NoahDorfman00/deskcal/hardware/stand/stl/clip.stl

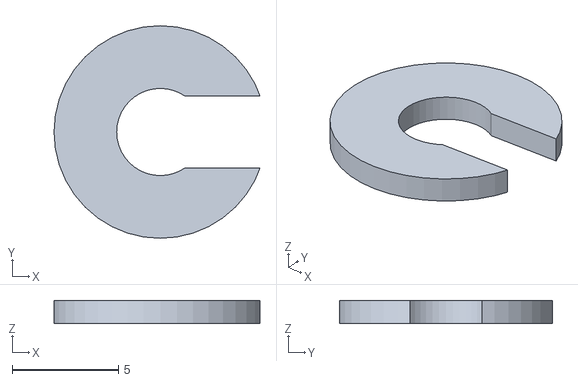
[picture p9: CAD file, 2026-10-13]
hardware/stand/stl/clip.stl
9.69 x 10.0 x 1.10
