NoahDorfman00/deskcal/hardware/stand/stl/handle.stl

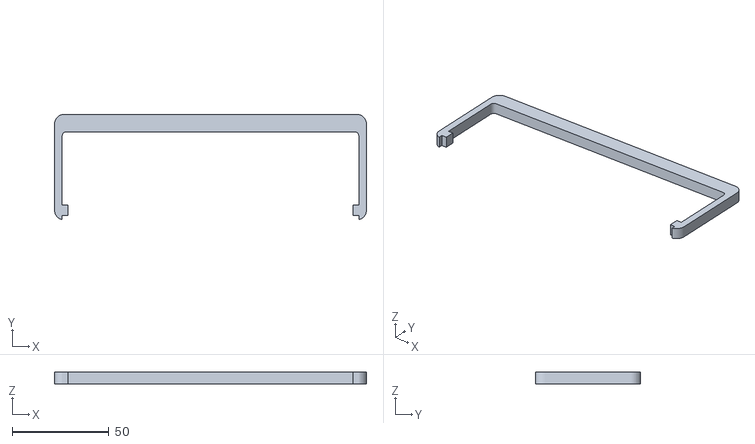
[picture p10: CAD file, 2026-10-13]
hardware/stand/stl/handle.stl
161.1 x 54.4 x 6.00
