NoahDorfman00/deskcal/hardware/stand/stl/bnc.stl

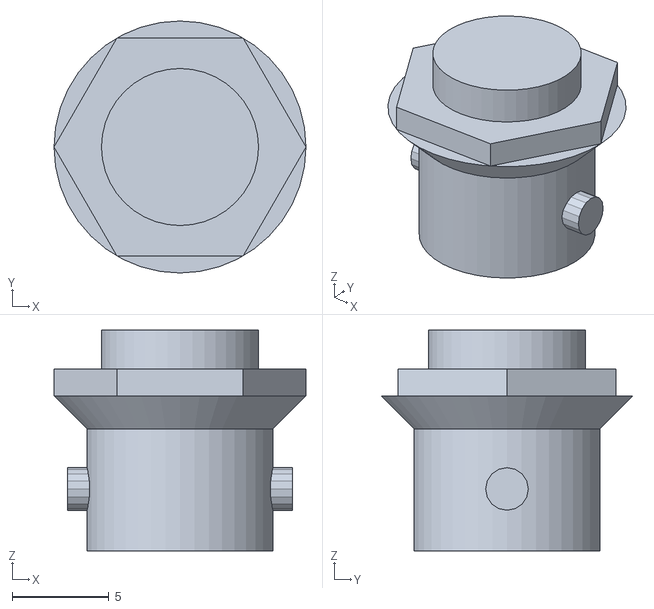
[picture p11: CAD file, 2026-10-13]
hardware/stand/stl/bnc.stl
13.0 x 13.0 x 11.4
