NoahDorfman00/deskcal/hardware/stand/stl/knob_big.stl

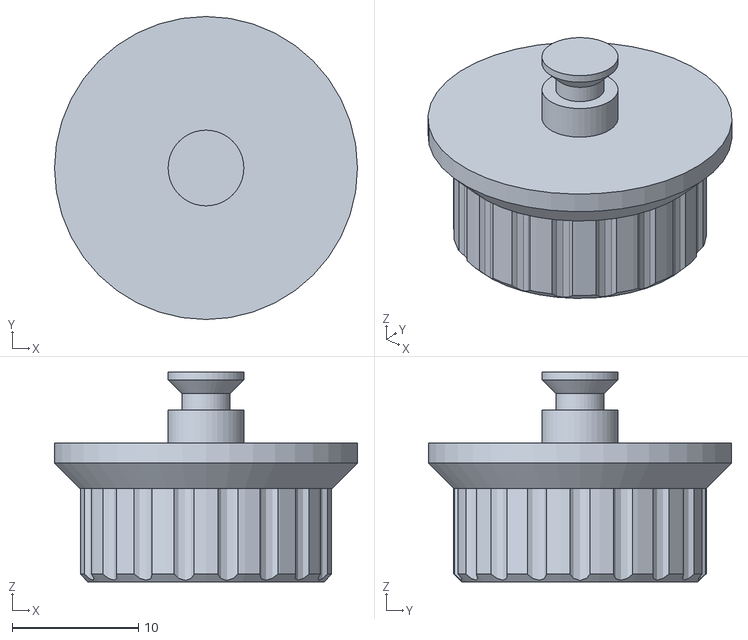
[picture p12: CAD file, 2026-10-13]
hardware/stand/stl/knob_big.stl
24.0 x 24.0 x 16.6
