NoahDorfman00/deskcal/hardware/stand/stl/lock.stl

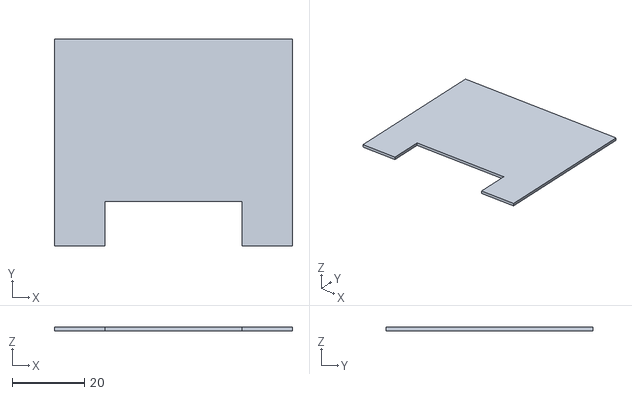
[picture p13: CAD file, 2026-10-13]
hardware/stand/stl/lock.stl
66.0 x 57.5 x 1.00
