NoahDorfman00/deskcal/hardware/stand/stl/knob_small.stl

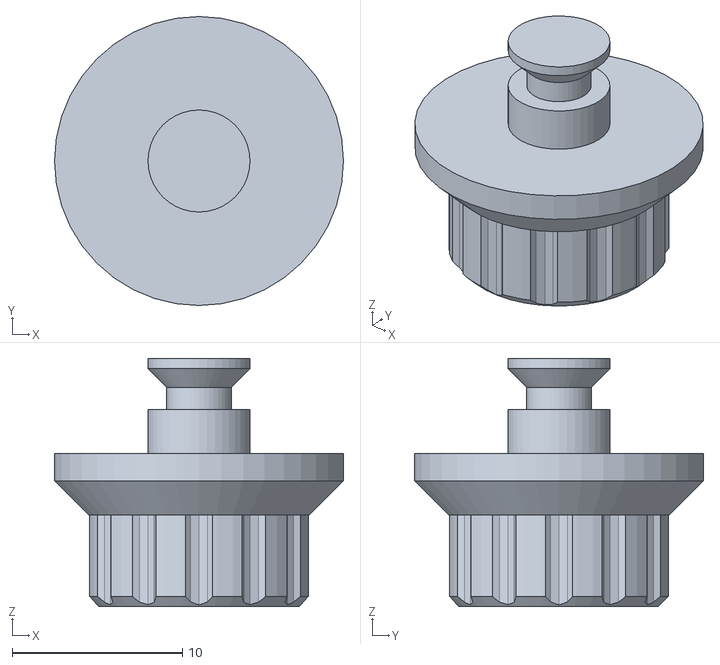
[picture p14: CAD file, 2026-10-13]
hardware/stand/stl/knob_small.stl
17.0 x 17.0 x 14.6
