NoahDorfman00/deskcal/hardware/stand/stl/body.stl

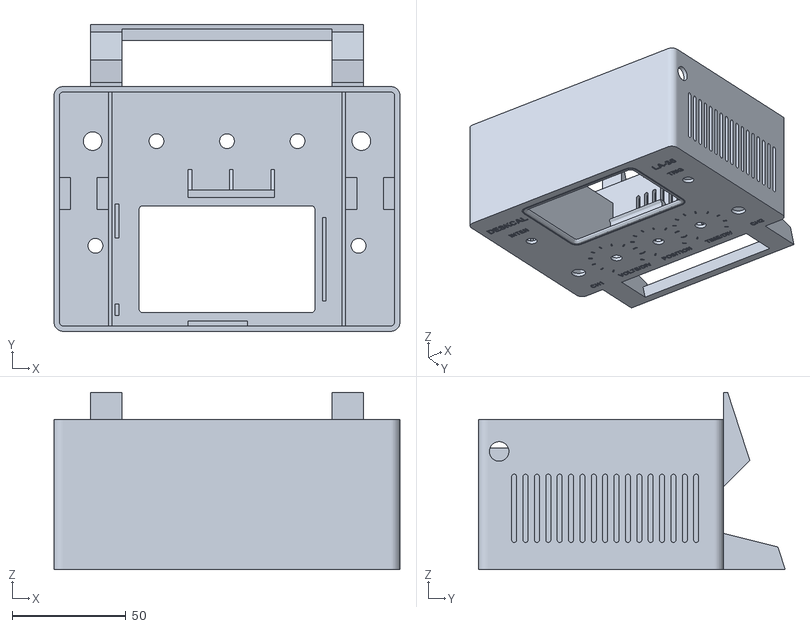
[picture p15: CAD file, 2026-10-13]
hardware/stand/stl/body.stl
152.1 x 134.8 x 78.0
