NoahDorfman00/deskcal/hardware/stand/stl/fit_test.stl

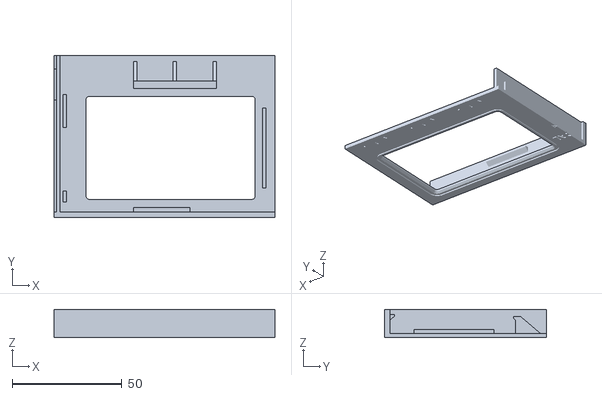
[picture p16: CAD file, 2026-10-13]
hardware/stand/stl/fit_test.stl
100.9 x 73.8 x 13.0
