NoahDorfman00/deskcal/hardware/stand/stl/back.stl

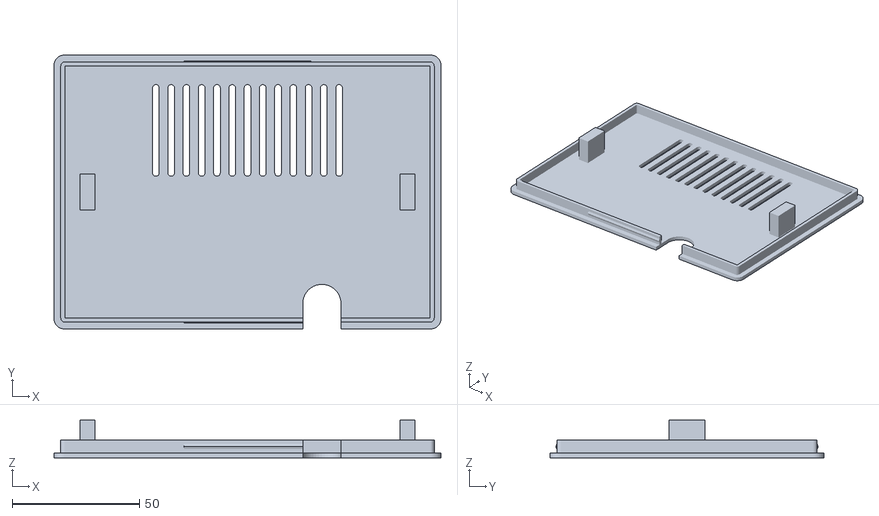
[picture p17: CAD file, 2026-10-13]
hardware/stand/stl/back.stl
152.1 x 107.6 x 14.9
