NoahDorfman00/deskcal/(commit log)

2026-10-09 Add Google Calendar API source with one-time --login
    For work accounts that block secret iCal links: read-only
    calendar.readonly access, loopback OAuth sign-in (works over an SSH
    tunnel), refresh token stored with 0600 perms, offline cache, and
    filtering of declined/working-location/out-of-office entries.
2026-10-13 Redesign the display as a logic analyzer and show collisions
    Replace the card layout with an hh:mm:ss countdown, a large title and a
    waveform of the next few hours in which every pulse is a meeting. The
    panel is about 70 x 50 mm, so nothing is drawn smaller than 32 px.
    Overlapping meetings are listed together under a red banner, with a
    second trace and a hatched band over the overlap. Bundle the Chakra
    Petch font (SIL OFL) instead of relying on a system font.
2026-10-13 Switch the display to a green phosphor monochrome palette
    Match the look of an old benchtop scope. With a single hue, collisions
    and the offline flag use inverse video, the second trace is a dimmer
    green, and the waveform gains an hourly graticule and a soft glow.
2026-10-13 Add a 3D-printable oscilloscope stand
    A parametric OpenSCAD case the Pi, screen, audio HAT and speakers slot
    into, with exported STLs, print and assembly notes, and photos of the
    screen fit test.
    [back.stl, bnc.stl, body.stl, clip.stl, deskcal_stand.scad, fit_test.stl, handle.stl, knob_big.stl]
2026-10-13 Fit the stand to the real speakers and add a photo of the print
    The speakers measure 45 mm front to back and about 102 mm tall with
    their wire, so the bays are taller, the back panel posts are shorter
    and the handle pins sit flush inside the case.
    [back.stl, body.stl, deskcal_stand.scad, fit_test.stl, handle.stl]
2026-10-15 Make the whole display a scope screen, and show clashes as interference
    - Draw a graticule across the whole face. Behind text it fades to a
    blurred, dimmer copy, the text gets a phosphor bloom, and faint
    scanlines and dark corners finish the CRT look.
    - The meeting waveform now uses the graticule as its timebase (40 min per
    division, 40 min back to 6 h ahead): the horizontal axis is time and the
    vertical axis is now, fading out into the text.
    - Traces are dim, lit by a beam that sweeps the screen like the
    screensaver's figure.
    - Double bookings no longer get a second trace. The single trace steps up
    once per meeting at once, sized to the busiest clash on screen, and
    rings and b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
